DRAMCO/EN-device-backscatter/simulations/cmos-voltage-dependent-resistor.asc

E1: e
M1: nmos; 2N7002
M2: nmos; 2N7002
R1: res; 100Meg
R2: res; 10k
V1: voltage; 1
Named nets: 0
.dc v1 0 3
