DRAMCO/EN-device-backscatter/hardware/design-v1_1.brd

## EAGLE design hardware/design-v1_1.brd (2023-05-19)

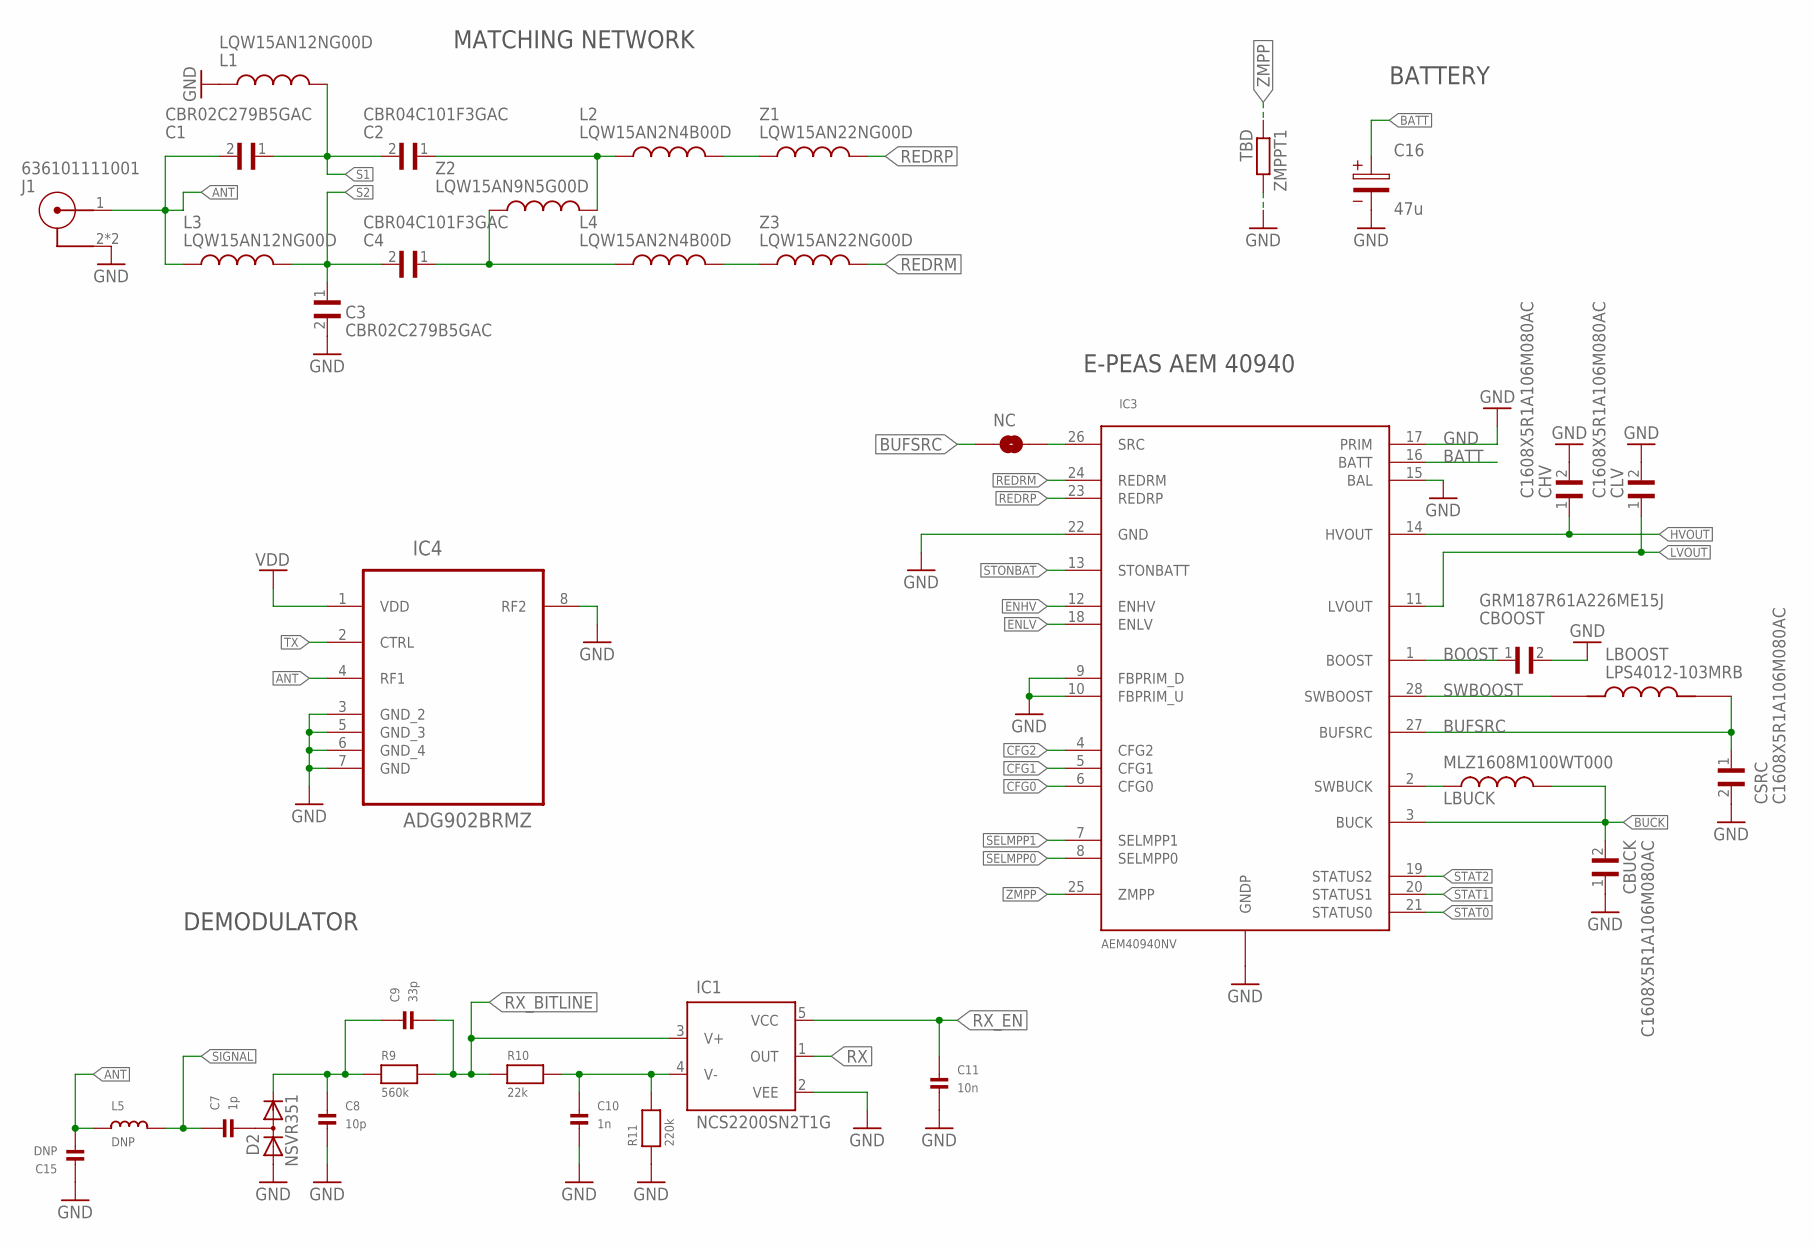
[picture p1: schematic design-v1_1.sch, sheet 1, Energy harvester]

Parts:
C1, C3: CBR02C279B5GAC; CAPC1005X55N
C2, C4: CBR04C101F3GAC; CAPC1005X55N
C7: 1p; 0402
C8: 10p; 0402
C9: 33p; 0402
C10: 1n; 0402
C11: 10n; 0402
C15: DNP; 0402
C16: 47u; 3X1.6X1.4(BXCXA)
CBOOST: GRM187R61A226ME15J; CAPC1608X80N
CBUCK: C1608X5R1A106M080AC; CAPC1608X90N
CHV: C1608X5R1A106M080AC; CAPC1608X90N
CLV: C1608X5R1A106M080AC; CAPC1608X90N
CSRC: C1608X5R1A106M080AC; CAPC1608X90N
D2: NSVR351; SOT23
IC1: NCS2200SN2T1G; SOT95P275X110-5N
IC3: AEM40940NV; QFN28_5X5_05P_NO_VIAS
IC4: ADG902BRMZ; SOP65P490X110-8N
J1: 636101111001
L1, L3: LQW15AN12NG00D; INDC1006X60N
L2, L4: LQW15AN2N4B00D; INDC1006X60N
L5: DNP; _0402
LBOOST: LPS4012-103MRB; IND_LPS4012-103MRB
LBUCK: MLZ1608M100WT000; INDC1608X95N
NC: JUMPER-SMT_2_NO_SILK; SMT-JUMPER_2_NO_SILK
R9: 560k; 0402
R10: 22k; 0402
R11: 220k; 0402
Z1, Z3: LQW15AN22NG00D; INDC1006X60N
Z2: LQW15AN9N5G00D; INDC1006X60N
ZMPPT1: TBD; R0805

Connections:
ANT: C1.2, C15.2, IC4.4 (RF1), J1.1, L3.1, L5.1
BATT: C16.1, IC3.16 (BATT); also elsewhere on the board
BOOST: CBOOST.1, IC3.1 (BOOST); also elsewhere on the board
BUCK: CBUCK.2, IC3.3 (BUCK), LBUCK.2; also elsewhere on the board
BUFSRC: CSRC.1, IC3.27 (BUFSRC), LBOOST.2, NC.2; also elsewhere on the board
CFG0: IC3.6 (CFG0); also elsewhere on the board
CFG1: IC3.5 (CFG1); also elsewhere on the board
CFG2: IC3.4 (CFG2); also elsewhere on the board
ENHV: IC3.12 (ENHV); also elsewhere on the board
ENLV: IC3.18 (ENLV); also elsewhere on the board
GND: C3.2, C8.2, C10.2, C11.2, C15.1, C16.2, CBOOST.2, CBUCK.1, CHV.2, CLV.2, CSRC.2, D2.1 (A), IC1.2 (VEE), IC3.9 (FBPRIM_D), IC3.10 (FBPRIM_U), IC3.15 (BAL), IC3.17 (PRIM), IC3.22 (GND), IC3.GND (GNDP), IC4.3 (GND_2), IC4.5 (GND_3), IC4.6 (GND_4), IC4.7 (GND), IC4.8 (RF2), J1.2, J1.3 (2), L1.1, R11.1, ZMPPT1.2; also elsewhere on the board
HVOUT: CHV.1, IC3.14 (HVOUT); also elsewhere on the board
LVOUT: CLV.1, IC3.11 (LVOUT); also elsewhere on the board
unnamed: C2.1, L2.1, Z2.2
unnamed: IC3.2 (SWBUCK), LBUCK.1
unnamed: C4.1, L4.1, Z2.1
unnamed: L2.2, Z1.1
unnamed: L4.2, Z3.1
unnamed: IC3.26 (SRC), NC.1
unnamed: C10.1, IC1.4 (V-), R10.2, R11.2
unnamed: C8.1, C9.1, D2.2 (C), R9.1
unnamed: C7.2, D2.3 (AC)
REDRM: IC3.24 (REDRM), Z3.2
REDRP: IC3.23 (REDRP), Z1.2
RX: IC1.1 (OUT); also elsewhere on the board
RX_BITLINE: C9.2, IC1.3 (V+), R9.2, R10.1
RX_EN: C11.1, IC1.5 (VCC); also elsewhere on the board
S1: C1.1, C2.2, L1.2; also elsewhere on the board
S2: C3.1, C4.2, L3.2; also elsewhere on the board
SELMPP0: IC3.8 (SELMPP0); also elsewhere on the board
SELMPP1: IC3.7 (SELMPP1); also elsewhere on the board
SIGNAL: C7.1, L5.2; also elsewhere on the board
STAT0: IC3.21 (STATUS0); also elsewhere on the board
STAT1: IC3.20 (STATUS1); also elsewhere on the board
STAT2: IC3.19 (STATUS2); also elsewhere on the board
STONBAT: IC3.13 (STONBATT); also elsewhere on the board
SWBOOST: IC3.28 (SWBOOST), LBOOST.1
TX: IC4.2 (CTRL); also elsewhere on the board
VDD: IC4.1 (VDD); also elsewhere on the board
ZMPP: IC3.25 (ZMPP), ZMPPT1.1

Notes on the sheet:
MATCHING NETWORK
E-PEAS AEM 40940
BATTERY
DEMODULATOR

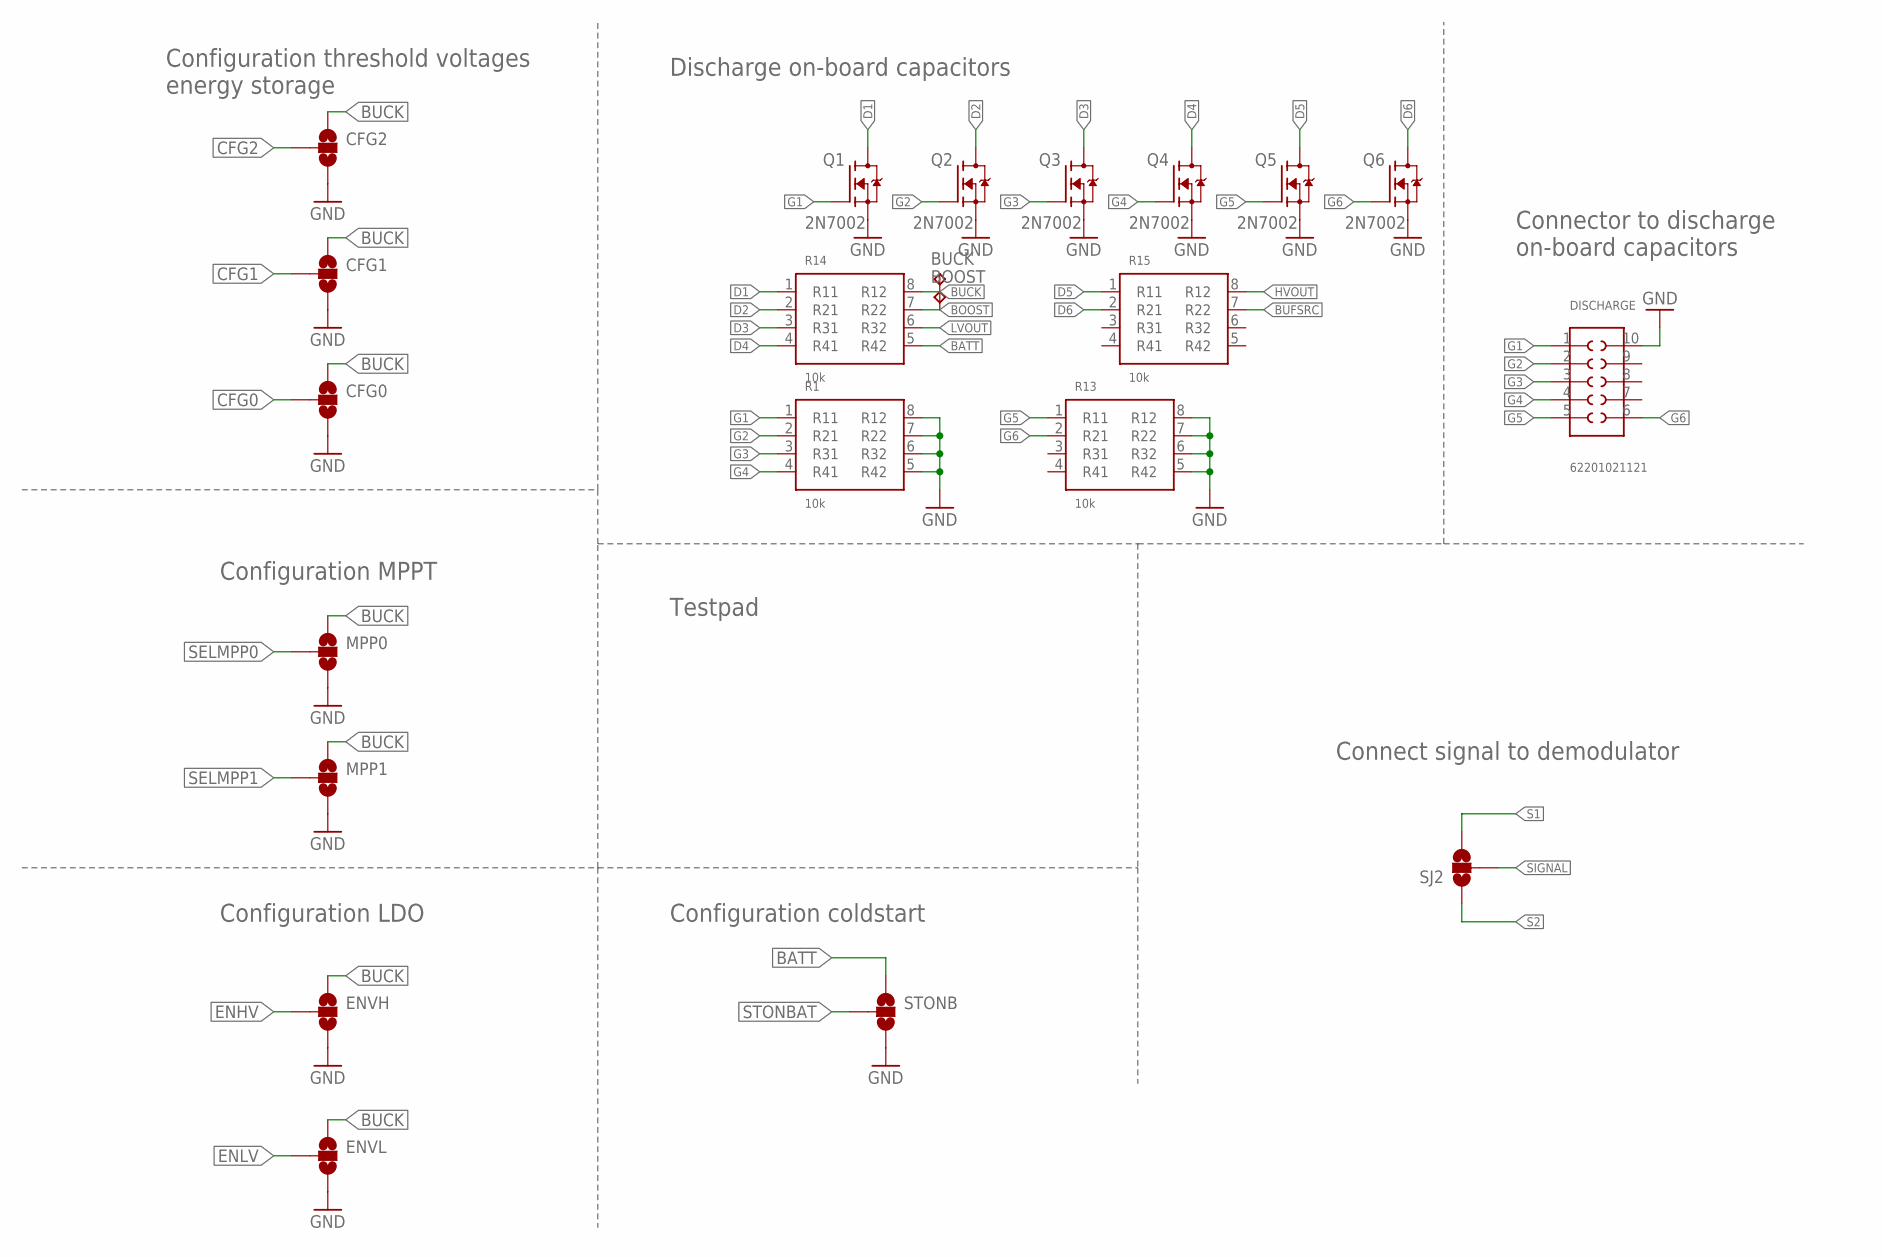
[picture p2: schematic design-v1_1.sch, sheet 2, Configurations]

Parts:
BOOST: TPTP06R; TP06R
BUCK: TPTP06R; TP06R
CFG0, CFG1, CFG2: JUMPER-SMT_3_NO_SILK; SMT-JUMPER_3_NO_SILK
DISCHARGE: 62201021121
ENVH: JUMPER-SMT_3_NO_SILK; SMT-JUMPER_3_NO_SILK
ENVL: JUMPER-SMT_3_NO_SILK; SMT-JUMPER_3_NO_SILK
MPP0, MPP1: JUMPER-SMT_3_NO_SILK; SMT-JUMPER_3_NO_SILK
Q1, Q2, Q3, Q4, Q5, Q6: 2N7002; SOT95P240X111-3N
R1, R13, R14, R15: 10k; RESCAXS50P200X100X45-8N
SJ2: SOLDERJUMPER_2WAYS; SJ_3
STONB: JUMPER-SMT_3_NO_SILK; SMT-JUMPER_3_NO_SILK

Connections:
BATT: R14.5 (R42), STONB.1; also elsewhere on the board
BOOST: BOOST.TP, R14.7 (R22); also elsewhere on the board
BUCK: BUCK.TP, CFG0.1, CFG1.1, CFG2.1, ENVH.1, ENVL.1, MPP0.1, MPP1.1, R14.8 (R12); also elsewhere on the board
BUFSRC: R15.7 (R22); also elsewhere on the board
CFG0: CFG0.2; also elsewhere on the board
CFG1: CFG1.2; also elsewhere on the board
CFG2: CFG2.2; also elsewhere on the board
D1: Q1.3 (D), R14.1 (R11)
D2: Q2.3 (D), R14.2 (R21)
D3: Q3.3 (D), R14.3 (R31)
D4: Q4.3 (D), R14.4 (R41)
D5: Q5.3 (D), R15.1 (R11)
D6: Q6.3 (D), R15.2 (R21)
ENHV: ENVH.2; also elsewhere on the board
ENLV: ENVL.2; also elsewhere on the board
G1: DISCHARGE.1, Q1.1 (G), R1.1 (R11)
G2: DISCHARGE.2, Q2.1 (G), R1.2 (R21)
G3: DISCHARGE.3, Q3.1 (G), R1.3 (R31)
G4: DISCHARGE.4, Q4.1 (G), R1.4 (R41)
G5: DISCHARGE.5, Q5.1 (G), R13.1 (R11)
G6: DISCHARGE.6, Q6.1 (G), R13.2 (R21)
GND: CFG0.3, CFG1.3, CFG2.3, DISCHARGE.10, ENVH.3, ENVL.3, MPP0.3, MPP1.3, Q1.2 (S), Q2.2 (S), Q3.2 (S), Q4.2 (S), Q5.2 (S), Q6.2 (S), R1.5 (R42), R1.6 (R32), R1.7 (R22), R1.8 (R12), R13.5 (R42), R13.6 (R32), R13.7 (R22), R13.8 (R12), STONB.3; also elsewhere on the board
HVOUT: R15.8 (R12); also elsewhere on the board
LVOUT: R14.6 (R32); also elsewhere on the board
S1: SJ2.3; also elsewhere on the board
S2: SJ2.1; also elsewhere on the board
SELMPP0: MPP0.2; also elsewhere on the board
SELMPP1: MPP1.2; also elsewhere on the board
SIGNAL: SJ2.2; also elsewhere on the board
STONBAT: STONB.2; also elsewhere on the board

Notes on the sheet:
Configuration threshold voltages energy storage
Configuration MPPT
Configuration LDO
Configuration coldstart
Testpad
Discharge on-board capacitors
Connector to discharge on-board capacitors
Connect signal to demodulator

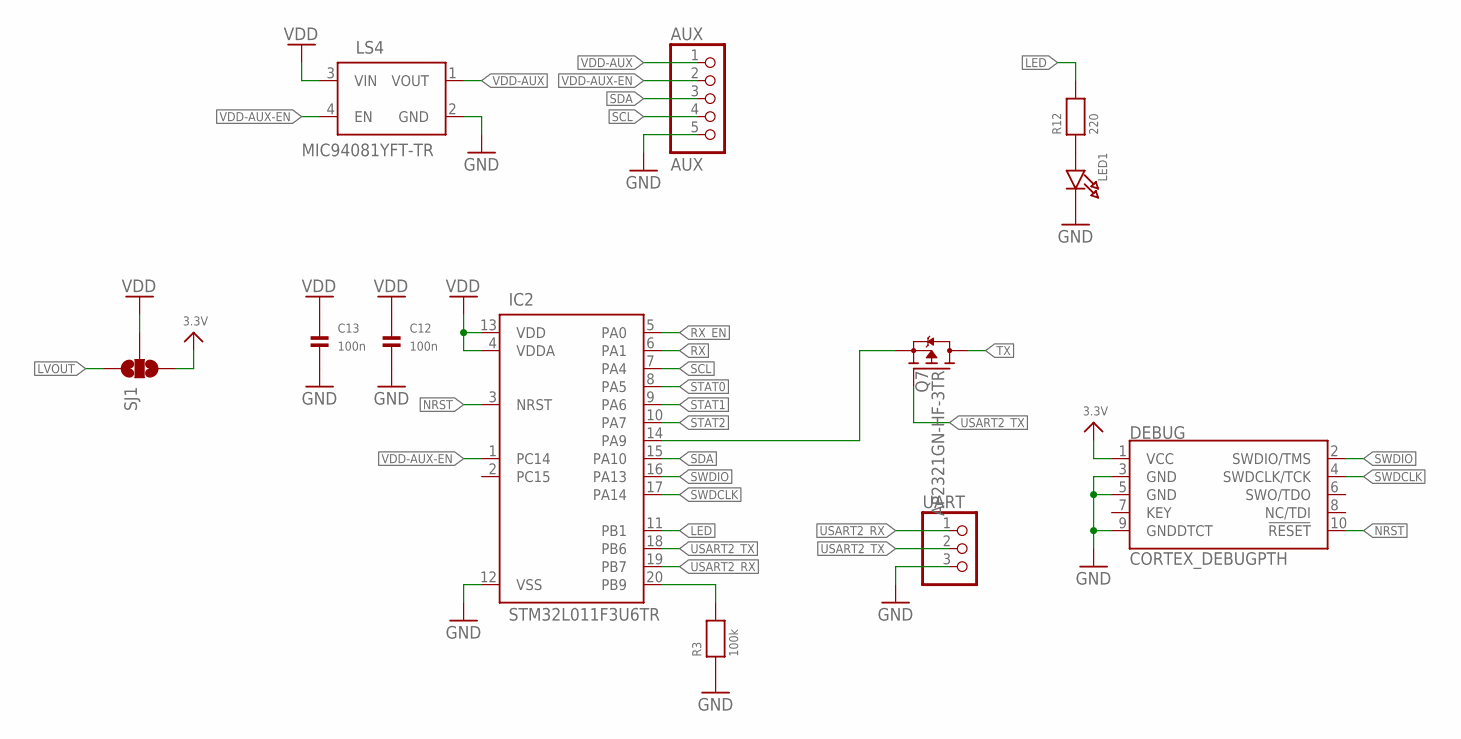
[picture p3: schematic design-v1_1.sch, sheet 3, MCU]

Parts:
AUX: AUX; 1X05_ROUND
C12, C13: 100n; 0402
DEBUG: CORTEX_DEBUGPTH; 2X5-PTH-1.27MM
IC2: STM32L011F3U6TR; QFN50P300X300X60-21N
LED1: LED0805; CHIPLED_0805
LS4: MIC94081YFT-TR; IC_MIC94081YFT-TR
Q7: AP2321GN-HF-3TR; SOT23-3
R3: 100k; 0402
R12: 220; 0603
SJ1: SOLDERJUMPER_2WAYS; SJ_3
UART: HEADER-1X3ROUND; 1X03_ROUND

Connections:
3.3V: DEBUG.1 (VCC), SJ1.3
GND: AUX.5, C12.2, C13.2, DEBUG.3 (GND), DEBUG.5 (GND), DEBUG.9 (GNDDTCT), IC2.12 (VSS), LED1.C, LS4.2 (GND), R3.1, UART.3; also elsewhere on the board
LED: IC2.11 (PB1), R12.2
LVOUT: SJ1.1; also elsewhere on the board
unnamed: IC2.14 (PA9), Q7.2 (S)
unnamed: LED1.A, R12.1
NRST: DEBUG.10 (!RESET), IC2.3 (NRST)
PB9: IC2.20 (PB9), R3.2
RX: IC2.6 (PA1); also elsewhere on the board
RX_EN: IC2.5 (PA0); also elsewhere on the board
SCL: AUX.4, IC2.7 (PA4)
SDA: AUX.3, IC2.15 (PA10)
STAT0: IC2.8 (PA5); also elsewhere on the board
STAT1: IC2.9 (PA6); also elsewhere on the board
STAT2: IC2.10 (PA7); also elsewhere on the board
SWDCLK: DEBUG.4 (SWDCLK/TCK), IC2.17 (PA14)
SWDIO: DEBUG.2 (SWDIO/TMS), IC2.16 (PA13)
TX: Q7.3 (D); also elsewhere on the board
USART2_RX: IC2.19 (PB7), UART.1
USART2_TX: IC2.18 (PB6), Q7.1 (G), UART.2
VDD: C12.1, C13.1, IC2.4 (VDDA), IC2.13 (VDD), LS4.3 (VIN), SJ1.2; also elsewhere on the board
VDD-AUX: AUX.1, LS4.1 (VOUT)
VDD-AUX-EN: AUX.2, IC2.1 (PC14), LS4.4 (EN)

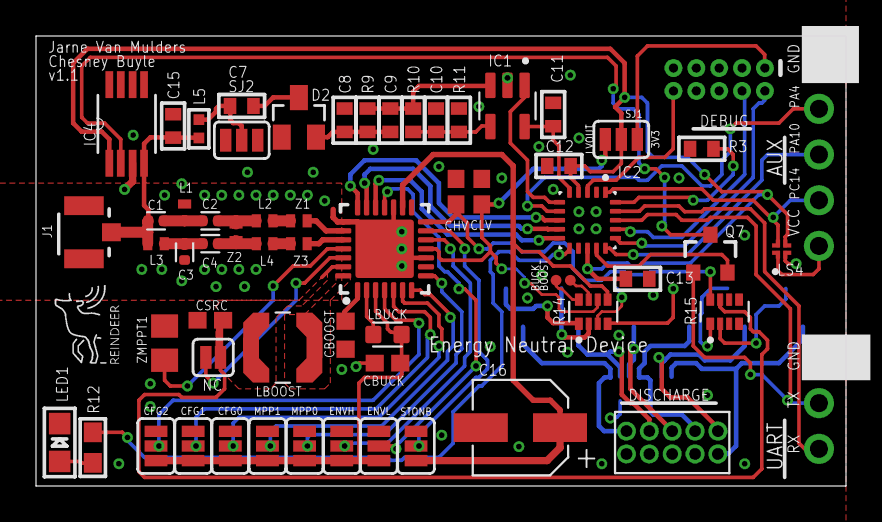
[picture p4: board design-v1_1.brd from above]

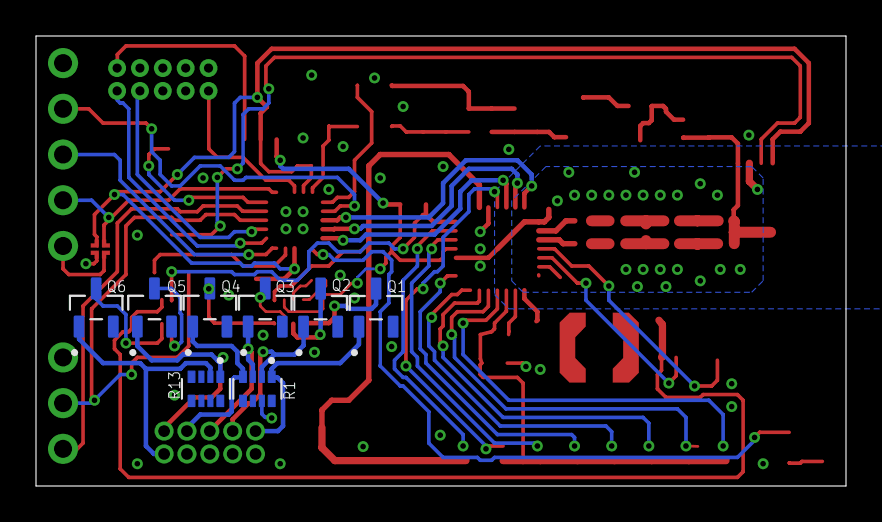
[picture p5: board design-v1_1.brd from below]

Board: 2 copper layers, 45.0 x 25.0 mm, 70 parts (8 on the bottom side), 66 nets.
