DRAMCO/EN-device-backscatter/firmware-vscode-exp-4b-part-2-pseudorandom/Core/Src/main.c

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
/* Includes ------------------------------------------------------------------*/
#include "main.h"

/* USER CODE BEGIN Includes */
#include "modulator.h"

#include <stdio.h>
#include <string.h> // Include the header for memcpy


/* USER CODE END Includes */

TIM_HandleTypeDef htim2;
TIM_HandleTypeDef htim21;

/* USER CODE BEGIN PV */
bc_handler_struct bc_handler;

/* USER CODE END PV */

void SystemClock_Config(void);
static void MX_GPIO_Init(void);
static void MX_TIM2_Init(void);
static void MX_TIM21_Init(void);
/* USER CODE BEGIN 0 */

const uint8_t code [] = { //10+4096
0xAA, 0xAA, 0xAA, 0xAA, 0xAA, 0xAA, 0xAA, 0xAA, 0xAA, 0xAA, 0x0C, 0x6E, 0x53, 0x78, 0xA7, 0x69, 0x46, 0x39, 0xC8, 0xBA,
0xD7, 0x24, 0x50, 0xB0, 0x38, 0x00, 0x84, 0x8D, 0xD4, 0x2C, 0xF0, 0xE5, 0xF4, 0x43, 0x4B, 0xC3, 0xEA, 0x7A, 0xDB, 0x03,
0x24, 0x27, 0x6C, 0xC5, 0x8B, 0xD5, 0x33, 0x9A, 0xB8, 0x88, 0xFB, 0x7C, 0xA9, 0xF7, 0x7C, 0xFB, 0x4E, 0x13, 0x72, 0xA5,
0x08, 0xC3, 0xE6, 0x8D, 0xC3, 0x87, 0xC4, 0x6E, 0x25, 0xA0, 0x5E, 0x12, 0x7E, 0xA4, 0x1C, 0x38, 0xBA, 0x1A, 0xFB, 0x80,
0x78, 0x7A, 0x6F, 0xF5, 0x56, 0x72, 0x86, 0x62, 0x0C, 0xCF, 0xDB, 0x1F, 0xEF, 0x4D, 0x1A, 0x3A, 0x9E, 0x96, 0x21, 0x00,
0xCC, 0xC7, 0x23, 0x24, 0x4B, 0x62, 0x4F, 0x26, 0x77, 0x4B, 0x30, 0x90, 0x8A, 0xC4, 0xCA, 0xDD, 0xF8, 0xC5, 0xFB, 0xF5,
0x13, 0x59, 0x92, 0x03, 0xBB, 0x7E, 0x78, 0xC0, 0xE9, 0xAC, 0xB3, 0xEE, 0xD0, 0x61, 0xE2, 0x45, 0x26, 0x01, 0x84, 0x3D,
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
  HAL_Init();

  /* Configure the system clock */
  SystemClock_Config();

  /* Initialize all configured peripherals */
  MX_GPIO_Init();
  MX_TIM2_Init();
  MX_TIM21_Init();
  /* USER CODE BEGIN 2 */

  HAL_TIM_OC_Start(&htim21,TIM_CHANNEL_2);
	HAL_TIM_Base_Start_IT(&htim2);

  //  Define time to send one byte
  uint8_t time_per_bit_ms = 1;
  uint16_t time_to_send_one_byte = time_per_bit_ms * 8;

  /* USER CODE END 2 */

  /* Infinite loop */
  /* USER CODE BEGIN WHILE */
  while (1)
  {
    /* USER CODE END WHILE */

    /* USER CODE BEGIN 3 */

    //  Use the transmit buffer from flash && Backscatter the data
    tx_send(&bc_handler, code, sizeof(code));

    //  Minimum delay to send buffer again
    HAL_Delay(sizeof(code)*time_to_send_one_byte);

    //  Optional, add additional delay between packet transmissions
    HAL_Delay(5000);
  }
  /* USER CODE END 3 */
}

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
/* USER CODE BEGIN 4 */

uint8_t counter = 0;

// Currently trigger at 104,8 Hz
void HAL_TIM_PeriodElapsedCallback(TIM_HandleTypeDef* htim)
{
	if(htim == &htim2){

    if(bc_handler.status == SENDING){

      uint16_t byte_value = bc_handler.buffer[bc_handler.current_byte];
      uint8_t bit_value = (byte_value >> bc_handler.current_bit) & 0x01;
      // printf("Byte %d, Bit %d: %u\n", current_byte, current_bit, bit_value);

      if(bit_value){
        HAL_TIM_OC_Start(&htim21,TIM_CHANNEL_2);
        HAL_GPIO_WritePin(LED_GPIO_Port, LED_Pin, GPIO_PIN_SET);
      }
      else{
        HAL_TIM_OC_Stop(&htim21,TIM_CHANNEL_2);
        HAL_GPIO_WritePin(LED_GPIO_Port, LED_Pin, GPIO_PIN_RESET);
      }

      // Update current_bit for next interrupt
      if (bc_handler.current_bit > 0) {
          bc_handler.current_bit--;
      } else {
        bc_handler.current_bit = 7;
        bc_handler.current_byte++;
        if (bc_handler.current_byte >= bc_handler.num_bytes) {
            
            //  Reset after reaching end of buffer
            bc_handler.current_byte = 0;

            //  Update status
            bc_handler.status = IDLE;

            //  Disable timer
            HAL_TIM_OC_Stop(&htim21,TIM_CHANNEL_2);
        }
      }
    }
	}
}

/* USER CODE END 4 */
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
