DRAMCO/EN-device-backscatter/firmware-vscode-exp-4b-part-2-pseudorandom/firmware-vscode-exp-4b-part-2-pseudorandom.ioc

Mcu.UserName=STM32L011F4Ux
PA9.Signal=S_TIM21_CH2
PB1.GPIO_Label=LED
PB1.Signal=GPIO_Output
