DRAMCO/EN-device-backscatter/(commit log)

2023-05-19 Add hardware folder and CAD files
    [design-v1_1.GBL, design-v1_1.GBO, design-v1_1.GBP, design-v1_1.GBS, design-v1_1.GTL, design-v1_1.GTO, design-v1_1.GTP, design-v1_1.GTS]
2023-12-13 Update tx frame format (first demodulation tests)
