DRAMCO/EN-device-backscatter/(notices)

Notices in the files:
firmware-vscode-exp-4b-part-2-pseudorandom/Core/Src/main.c:
Copyright (c) 2024 STMicroelectronics.
All rights reserved.
This software is licensed under terms that can be found in the LICENSE file
parts and their libraries:
SparkFun-Jumpers: Licensing: Creative Commons ShareAlike 4.0 International - https://creativecommons.org/licenses/by-sa/4.0
Eagle_WR-UMRF: Copyright: Würth Elektronik
supply0: Copyright (C) 2007, Bob Starr
